Apras4356/Security-System/docs/IMG_20260613_052000.jpg

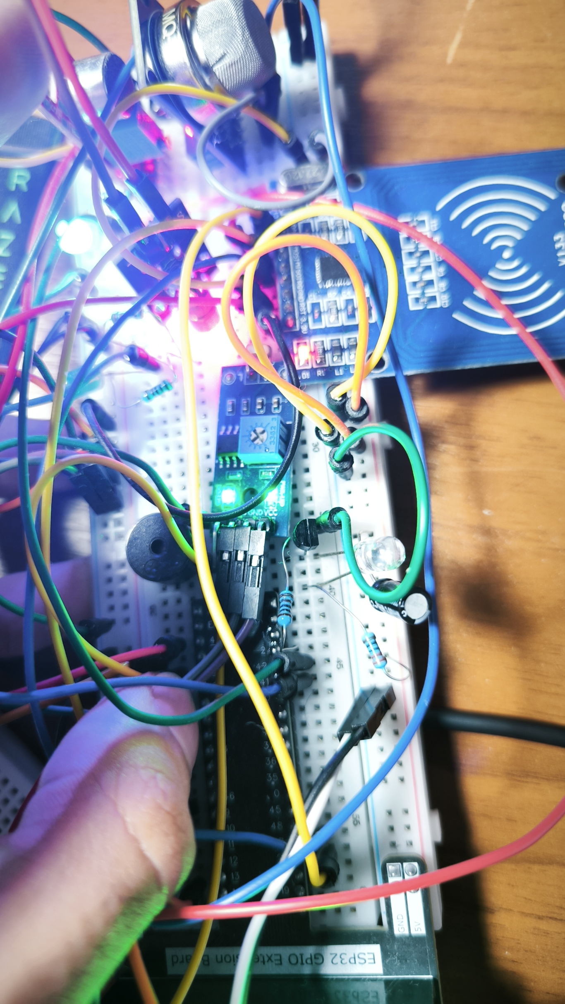
docs/IMG_20260613_052000.jpg
