Apras4356/Security-System/docs/Security System Documentation.odt

# 📖 Documentation: IoT Security System

This documentation covers the architecture, hardware connections, and software configuration for a dual-ESP32 IoT security system. The system is split into two microcontrollers:

1. The Brain (ESP32-S3): Handles the web server, RFID access control database, laser tripwire logic, and Telegram API notifications.
2. The Mouth (ESP32): A dedicated audio co-processor that acts as a Bluetooth A2DP Source to loop a siren over a wireless speaker when triggered.

## 1. System Overview: Audio Co-Processor ("The Mouth")

This code runs on a secondary ESP32 microcontroller dedicated entirely to handling wireless audio playback. It connects to a specific Bluetooth speaker (EDIFIER S351DB). It waits in standby mode, silently listening to a Serial (UART) connection. When it receives a trigger command from the primary Security Panel ESP32 ("The Brain"), it instantly loops a pre-loaded raw audio file (PCM) and activates a visual warning LED.

Offloading the Bluetooth A2DP stream to this secondary board is crucial, as audio processing consumes significant memory and CPU cycles that would otherwise destabilize the primary web server and RFID scanner.

## 2. Hardware Connections & Pinout

To facilitate communication, the two ESP32s must be wired together using their Hardware UART pins.

- Pin 16 (RX2): Connects to the TX2 pin of the Main ESP32. Receives commands.
- Pin 17 (TX2): Connects to the RX2 pin of the Main ESP32. (Optional, used if the Mouth ever needs to send acknowledgment data back).
- Pin 22: Data pin for the WS2812B NeoPixel RGB LED.
- GND: You must connect the Ground (GND) pins of both ESP32s together. Without a shared ground, the Serial communication will fail or transmit garbage data.

## 3. Library Dependencies

Ensure the following libraries are installed in your Arduino IDE or PlatformIO environment:

- Adafruit_NeoPixel: Manages the RGB LED state.
- ESP32-A2DP (by pschatzmann): The core library that provides BluetoothA2DPSource.h to turn the ESP32 into a Bluetooth audio broadcaster.
- seinagermos.h: A custom, local header file containing the raw PCM audio data stored as a C-array (seinagermos), along with its length (seinagermos_len). (See Section 7 for creation instructions).

## 4. Core Architecture & Logic

### State Management

The system relies on a single volatile boolean flag: isAlarmTriggered.

- When false: The Bluetooth stream outputs pure silence (zeros). The LED is off.
- When true: The Bluetooth stream reads from the seinagermos.h array, looping infinitely. The LED turns solid red.

### Audio Streaming Callback (get_audio_data)

This is the heart of the Bluetooth audio generation. The A2DP library constantly runs this function in the background, requesting chunks of audio data to transmit to the Bluetooth speaker.

1. Silence Generation: If the alarm is disarmed (!isAlarmTriggered), it feeds 0 to both the left and right audio channels. This keeps the Bluetooth connection alive without producing sound.
2. Audio Playback: If triggered, it pulls the exact audio frame from the seinagermos PCM array.
3. Infinite Looping: It tracks its position using current_pcm_index. If this index hits the total number of frames, it instantly snaps back to 0, creating an endless, seamless siren loop.

## 5. Function Reference

### setup()

- Initializes the primary serial monitor (115200 baud) for debugging.
- Initializes the hardware UART serial port (Serial2 at 9600 baud) to communicate with the Main ESP32.
- Turns off the NeoPixel LED.
- Initiates the Bluetooth search and connection exclusively to the designated speaker.

### loop()

This function strictly monitors the UART serial buffer for incoming 1-byte character commands from the Main ESP32.

- Receiving 'A' (Alarm):
  - Resets the audio track to the very beginning (current_pcm_index = 0).
  - Sets isAlarmTriggered = true to unmute the audio stream.
  - Turns the NeoPixel LED bright Red.
- Receiving 'S' (Stop/Standby):
  - Sets isAlarmTriggered = false to instantly mute the audio stream.
  - Turns the NeoPixel LED off.

## 6. Integration Notes (How the Boards Talk)

When the Main ESP32's laser tripwire is broken, the Brain runs triggerSeinagermos(), which executes Serial2.println("A");. This fires the 'A' character over the RX/TX wires to Pin 16 of this secondary ESP32, instantly triggering the Bluetooth speaker. When a valid RFID card is scanned, the Brain runs disarmSystem(), executing Serial2.println("S");, forcing this secondary board to mute itself.

## 7. Audio File Conversion Guide (Creating seinagermos.h)

Because the ESP32 lacks a traditional file system, the raw audio waves must be translated into hexadecimal numbers (e.g., 0xFA, 0x1B) and stored directly in the ESP32's flash memory.

Memory Constraint Warning: Uncompressed raw audio is large. Keep your siren loop between 2 to 4 seconds maximum (~350KB to 700KB) to ensure it fits comfortably within the ESP32's available program memory.

### Step 7.1: Format the Audio in Audacity

The Bluetooth A2DP library requires a strict audio format: 44.1kHz, 16-bit, Stereo.

1. Open your audio file in Audacity.
2. Convert to Stereo: If the track is Mono, duplicate it and join the two tracks to create a Stereo track.
3. Set Project Rate: In the bottom left corner, change the Project Rate (Hz) to 44100.
4. Trim the audio to a clean 2-3 second loop.

### Step 7.2: Export as RAW PCM

1. Go to File > Export > Export Audio.
2. Apply the following settings exactly:
  - Save as type / Format: Other uncompressed files
  - Header: RAW (header-less)
  - Encoding: Signed 16-bit PCM
3. Export the file as seinagermos.raw. Check the file properties on your computer and note the exact file size in bytes—you will need this number.

### Step 7.3: Convert the RAW file to a C-Array

1. Use a hex converter tool, such as tomeko.net's File to C array converter.
2. Upload seinagermos.raw and convert it.
3. Copy the resulting output (the block of text starting with 0x00, 0x00...).

### Step 7.4: Create the Header File

1. In your project, create a new file named seinagermos.h.
2. Paste the following template, inserting your specific byte length and hex data:

C++

#pragma once

#include <stdint.h>

#include <pgmspace.h> // Forces the ESP32 to save this in flash memory, not RAM

// IMPORTANT: Replace '352800' with the exact file size (in bytes) of your .raw file

const uint32_t seinagermos_len = 352800;

// Paste your converted hex data between the brackets

const uint8_t seinagermos[] PROGMEM = {

// PASTE YOUR HEX DATA HERE:

0x00, 0x00, 0x00, 0x00, 0xFE, 0xFF, 0x1A, 0x2B, // ...

};

Note: The PROGMEM keyword is critical. Without it, the ESP32 will try to load the entire audio file into its active RAM and crash instantly.

## 8. PlatformIO Configurations (platformio.ini)

Because this project utilizes heavy audio processing and a complex web server/database, standard Arduino IDE compiler settings will fail. The platformio.ini files for both boards are specifically tuned for these workloads.

### The "Brain" Configuration (Security Panel)

Ini, TOML

[env:4d_systems_esp32s3_gen4_r8n16]

platform = espressif32

board = 4d_systems_esp32s3_gen4_r8n16

framework = arduino

monitor_speed = 115200

lib_deps =

adafruit/Adafruit NeoPixel@^1.15.4

marcoschwartz/LiquidCrystal_I2C@^1.1.4

miguelbalboa/MFRC522@^1.4.12

- Architecture: Uses the ESP32-S3 (4d_systems_esp32s3_gen4_r8n16), providing ample RAM to chew through web server rendering, array shifting for the RFID database, and secure HTTPS API requests.
- Native Core Libraries: Libraries like WiFi, WebServer, Preferences, HTTPClient, and ESPmDNS are native to the espressif32 core. Therefore, they do not need to be declared in lib_deps to prevent dependency conflicts.

### The "Mouth" Configuration (Audio Co-Processor)

Ini, TOML

[env:esp32doit-devkit-v1]

platform = espressif32

board = esp32doit-devkit-v1

framework = arduino

board_build.partitions = huge_app.csv

monitor_speed = 115200

lib_ldf_mode = deep+

upload_speed = 115200

lib_deps =

adafruit/Adafruit NeoPixel@^1.15.4

https://github.com/pschatzmann/ESP32-A2DP.git

- board_build.partitions = huge_app.csv (Critical): By default, PlatformIO allocates ~1.2MB for code. The Bluetooth A2DP library combined with the giant seinagermos.h raw audio array will trigger a "Sketch too large" compiler error. The huge_app.csv partition scheme wipes out the OTA (Over-The-Air) update space, allocating a massive 3MB block for your program to fit perfectly.
- lib_ldf_mode = deep+: The ESP32-A2DP library features complex, nested dependencies. This directive forces the PlatformIO Library Dependency Finder (LDF) to parse all nested headers thoroughly, preventing random "Header file not found" compilation errors.
- Direct Git Sourcing: Pulling the A2DP library directly from its GitHub repository ensures the compiler grabs the latest Bluetooth stability patches instead of relying on outdated registry versions.
- Upload Speed: Set safely at 115200 to prevent corruption of the large audio array over the USB cable. (Note: Flashing will take 30-60 seconds. If impatient, this can be safely tested at 921600 depending on the quality of your USB cable).

## 🔌 Hardware Wiring Guide & Pinout

This section details the exact physical connections required to link the microcontrollers, sensors, and peripherals.

### 1. Power Distribution (Critical!)

Proper power management is the most important part of this build. Failure to wire the grounds correctly will result in serial communication failure between the two boards.

⚠️ CRITICAL: Shared Ground

The GND pin on "The Brain" MUST be physically connected to the GND pin on "The Mouth". All modules (RFID, Mic, Laser, Buzzer, LCD, LEDs) must also share this common ground.

- 3.3V Logic: Connect the 3.3V pin on the ESP32-S3 to the VCC/3.3V pins on the RFID, Microphone, and Laser modules.
- 5V Logic: Connect the 5V (or VIN/VBUS) pin to the VCC on the I2C LCD Screen. (Note: Most I2C LCDs require 5V to power the backlight and display text clearly).

### 2. "The Brain" (ESP32-S3 Security Panel)

This board handles the core logic, web server, and sensor monitoring.

Component | ESP32-S3 Pin | Code Variable | Function / Notes
Mouth ESP32 (RX) | Pin 17 | TX2_PIN | Sends 'A' and 'S' serial commands to the Mouth.
Mouth ESP32 (TX) | Pin 16 | RX2_PIN | Receives data. (Optional, but good practice)
RFID Reader (SDA/SS) | Pin 21 | SS_PIN | SPI Chip Select
RFID Reader (SCK) | Pin 12 | SPI_SCK | SPI Clock
RFID Reader (MOSI) | Pin 11 | SPI_MOSI | SPI Master Out Slave In
RFID Reader (MISO) | Pin 13 | SPI_MISO | SPI Master In Slave Out
RFID Reader (RST) | Pin 14 | RST_PIN | Hardware Reset
LCD Screen (SDA) | Pin 8 | I2C_SDA | I2C Data Line
LCD Screen (SCL) | Pin 9 | I2C_SCL | I2C Clock Line
Microphone (OUT) | Pin 4 | MIC_PIN | Digital out from sound sensor
Laser Receiver (OUT) | Pin 5 | laserReceiverPin | Digital out from light sensor
Buzzer (+) | Pin 6 | BUZZER_PIN | Active buzzer PWM control
Wi-Fi LED (+) | Pin 42 | wifiLed | Needs a 220Ω-330Ω resistor in series to GND
Arming Button | Pin 47 | resetButton | Connects to 3.3V when pressed (Active HIGH)
RGB Status LED | Pin 48 | LED_RGB | Data pin for the WS2812 NeoPixel

### 3. "The Mouth" (ESP32 Audio Co-Processor)

This board strictly handles the Bluetooth A2DP audio streaming and warning lights.

Component | ESP32 Pin | Code Variable | Function / Notes
Brain ESP32 (TX) | Pin 16 | RX2_PIN | Receives 'A' and 'S' commands from the Brain.
Brain ESP32 (RX) | Pin 17 | TX2_PIN | Sends data back. (Optional)
Warning RGB LED | Pin 22 | N/A | Data pin for the visual warning NeoPixel

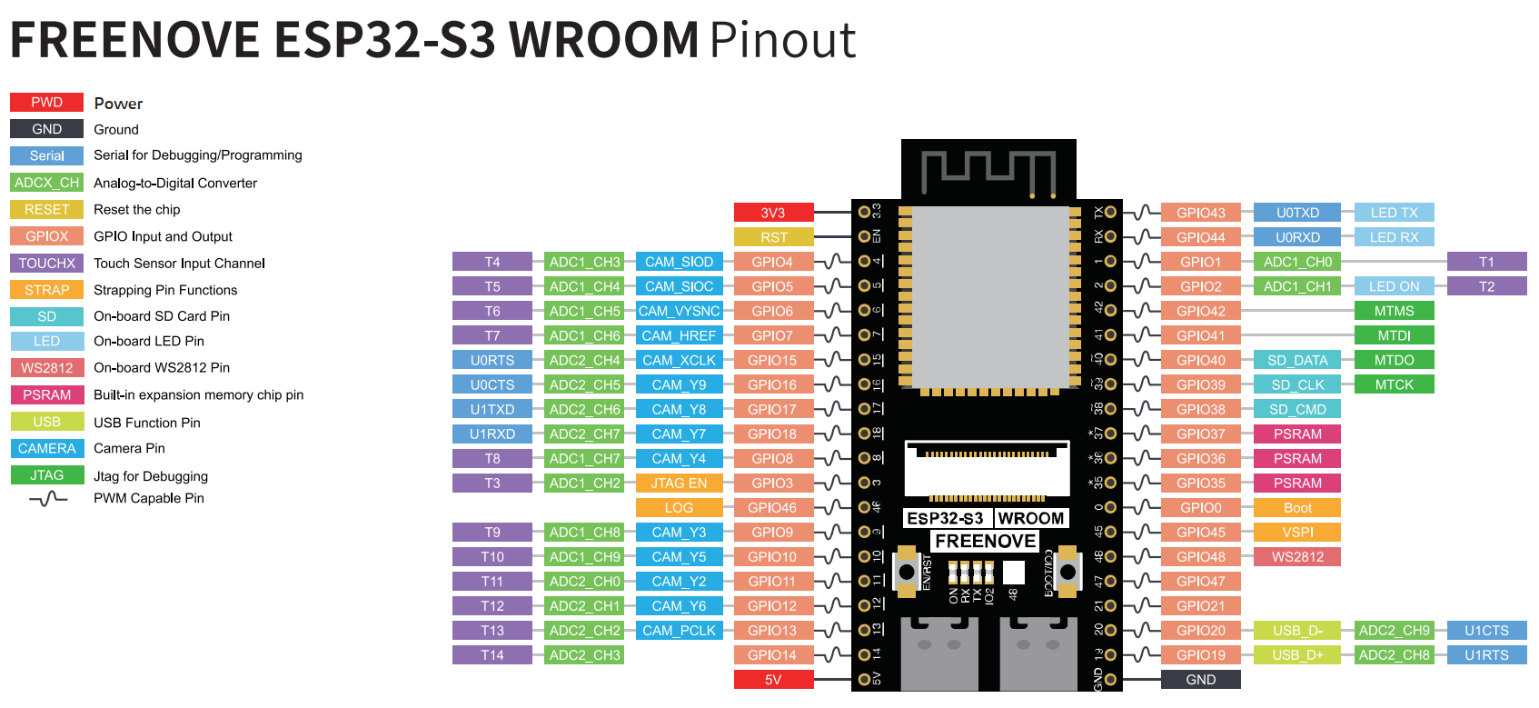
[picture p2: figure]
