Apras4356/Security-System/docs/Παρουσίαση Hackathon Integrated secure system.odp

## Hackathon 2026 Omnishield Omnimesh | Integrated secure room technology Μέλη ομάδας: Γκιουζελάκης Αναστάσιος Τσαπακίδης Γιώργος Συνοπτική περιγραφή: Σύστημα ασφαλείας με έλεγχο πρόσβασης μέσω κινητού και ιστοσελίδας

## Ορισμός του προβλήματος

Το πρόβλημα που καλούμαστε να λύσουμε στα πλαίσια του 2ήμερου HACKATHON, είναι η έλλειψη ενός χαμηλού κόστους access control και security system, αξιόπιστου με βάση το κόστος του χώρου που προστατεύει και ταυτόχρονα η εύκολη εγκατάσταση του συστήματος.

## Διαφοροποίηση με ανταγωνιστές

Με το ελάχιστο δυνατό κόστος και αξιοποιώντας όσες το δυνατόν περισσότερες ηλεκτρικές συσκευές είναι διαθέσιμες σε ένα σπίτι, δημιουργούμε έναν μηχανισμό ασφαλείας, που αποτελείται από access control κεντρικής εισόδου, microcontroller ESP32 και ένα κινητό. Επιπλέον εξαρτήματα είναι διαθέσιμα, ανάλογα με τις ανάγκες του χώρου.

## Λύση του προβλήματος & καινοτομία της ιδέας

Η ομάδα μας ανέπτυξε ένα οικονομικά αποδοτικό, πλήρως παραμετροποιήσιμο και εκπαιδευτικά επωφελές σύστημα με χρήση μικροελεγκτή ESP32 custom λογισμικό ξεκινώντας από την επιχειρηματική έρευνα που υποστηρίζει το Ε.Μ.Π ως SPIN-OFF με στόχο να εξελιχθεί σε μια μελλοντική, εμπορικά βιώσιμη λύση στην αγορά του οικιακού αυτοματισμού και ασφάλειας.

Παρέχουμε το σύστημα σε 2 εκδόσεις.

- Home edition | Omnishield Home
- Professional | Omnishield Pro

## Ευκαιρίες αγοράς

- 1. Στάδιο
  Πιλοτική λειτουργία του προϊόντος μας στη σχολή Πολιτικών Μηχανικών Ε.Μ.Π.
  Εμφάνιση σφαλμάτων.
  Καταγραφή προβλημάτων δοκιμών.
  Επιδιόρθωση προβλημάτων πιλοτικής λειτουργίας.

## Ευκαιρίες αγοράς

- 2ο στάδιο.
  Διάθεση του προϊόντος στην αγορά.
  Target group: Ιδιώτες, που θέλουν για την ασφάλεια του χώρου τους, δαπανώντας ποσό κάτω του μέσου όρου κόστους συστημάτων συναγερμού του εμπορίου.

## Ευκαιρίες αγοράς

- Το κόστος αγοράς αντίστοιχων εξαρτημάτων κυμαίνεται από 100 έως 300€ (πηγή aliexpress).
- Το κόστος υλικών της υπηρεσίας μας ξεκινάει από 50€ και αυξάνεται ανάλογα με τα παρελκόμενα που θέλει να προσθέσει ο τελικός χρήστης.

## Λειτουργία προϊόντος

- Wifi mesh για ανίχνευση κίνησης με τον βασικό εξοπλισμό μέσω του router και πρόσθετων access point συσκευών.
- Χρήση ήδη υπάρχοντων συσκευών για την εξασφάλιση της ασφάλειας (πχ ηχεία, κάμερα, ανιχευτής φωτιάς).
- Sensor Fusion κάμερας και wifi για τη συγχώνευση δεδομένων.
- Υποστήριξη access control για εξατομικευμένη πρόσβαση σε χώρους
- Απομακρυσμένη πρόσβαση για παραμετροποίηση και έλεγχο του συστήματος
- Ευκολία τοποθέτησης, plug and play, με ελάχιστο χρόνο εγκατάστασης

## Κοινωνικό αποτύπωμα της λύσης

- Ο μηχανισμός μπορεί να μεταμορφωθεί σε σύστημα υποστήριξης ευάλωτων ομάδων. Για παράδειγμα, η ανάλυση του σήματος WiFi μπορεί να ανιχνεύσει πτώση ή παρατεταμένη ακινησία ενός ηλικιωμένου, στέλνοντας αυτόματη ειδοποίηση στους οικείους του.
- Δεν απευθύνεται μόνο σε ανθρώπους που θέλουν να κατανοήσουν, να τροποποιήσουν και να επεκτείνουν την τεχνολογία του σπιτιού τους, αλλά και στον μέσο ιδιώτη που θέλει μια εύκολη λύση, αποδεικνύοντας ότι η τεχνολογία χαμηλού κόστους μπορεί να έχει υψηλή τεχνολογική αξία.

## Ερωτήσεις;

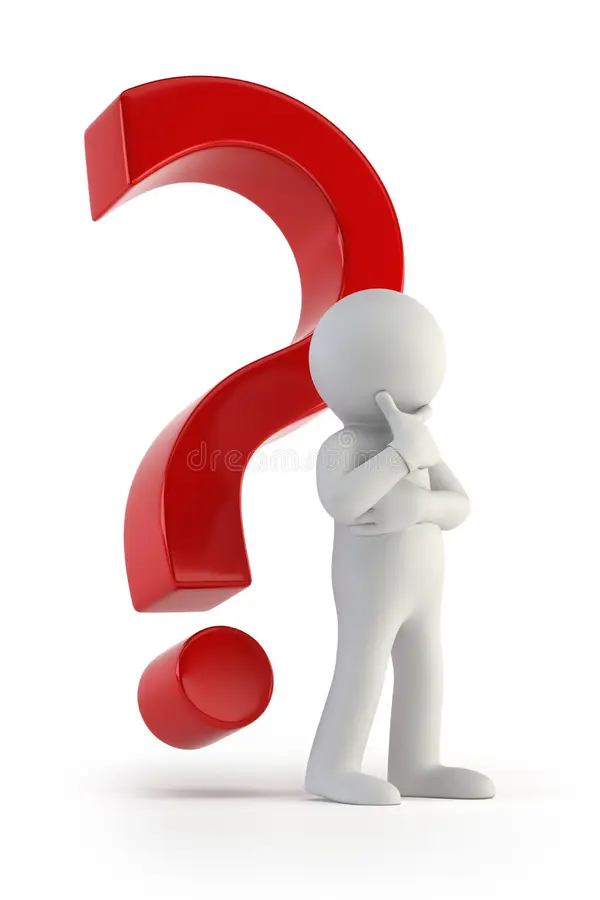
[picture p4: figure]

## Ευχαριστίες

Ευχαριστούμε το κέντρο καινοτομίας και επιχειρηματικότητας του Ε.Μ.Π για την ευκαιρία να συμμετάσχουμε στο HACKATHON @ NTUA
