Apras4356/Security-System/hardware/3d-models/outside module 1.stl

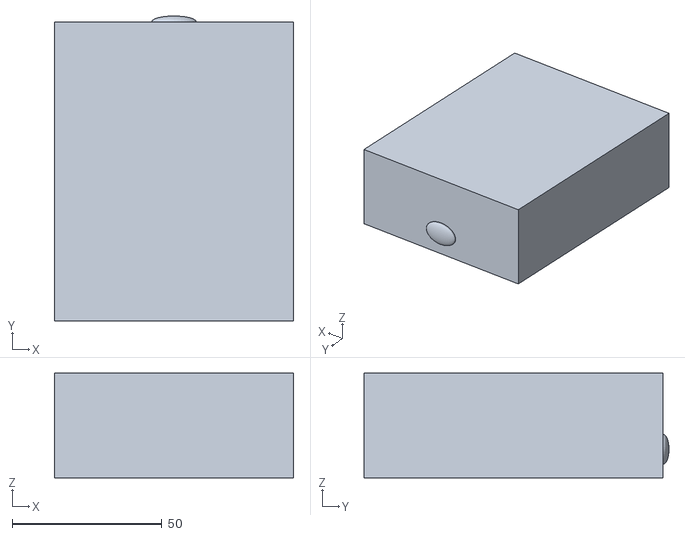
[picture p5: CAD file, 2026-11-09]
hardware/3d-models/outside module 1.stl
80.0 x 102.0 x 35.0
