Apras4356/Security-System/hardware/3d-models/Enclosure_Lid.stl

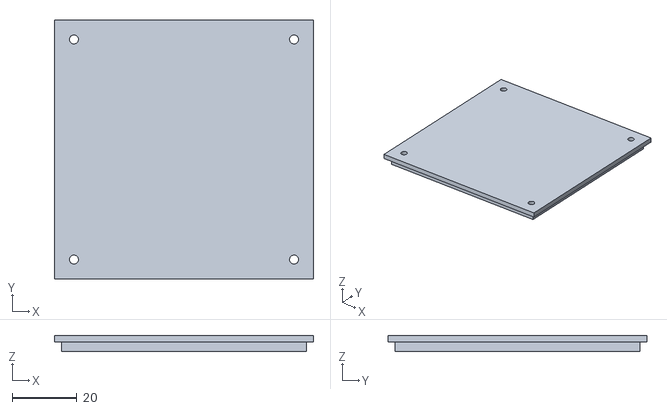
[picture p6: CAD file, 2026-11-09]
hardware/3d-models/Enclosure_Lid.stl
80.0 x 80.0 x 5.00
