Apras4356/Security-System/hardware/3d-models/Base.stl

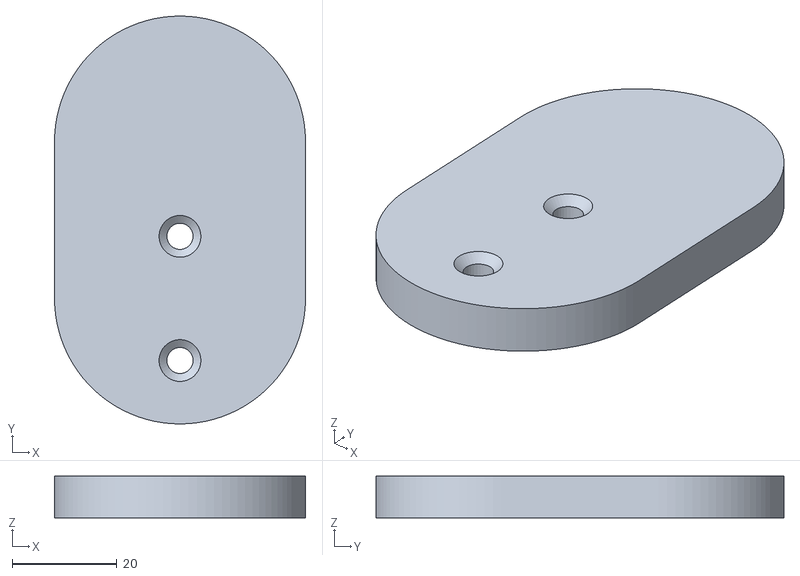
[picture p7: CAD file, 2026-11-09]
hardware/3d-models/Base.stl
48.0 x 78.0 x 8.00
