Apras4356/Security-System/hardware/3d-models/freecad box.FCStd

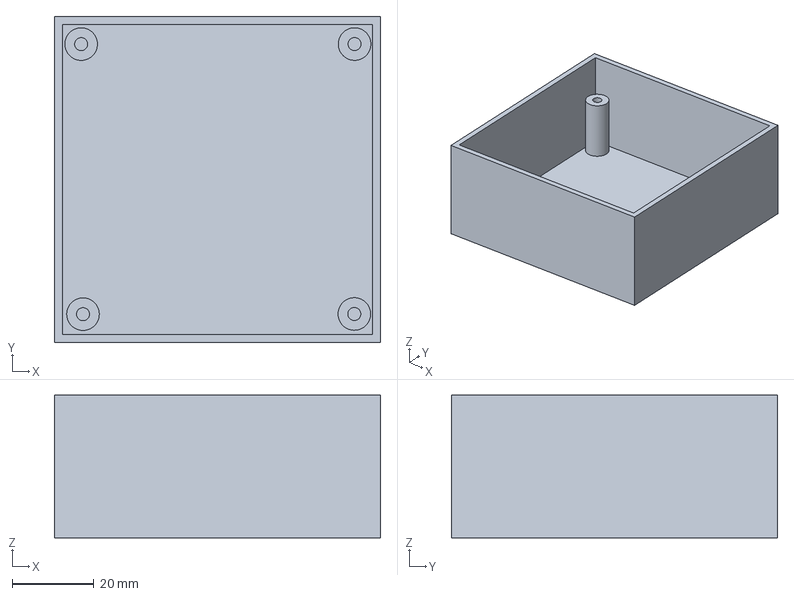
[picture p8: CAD file, 2026-11-09]
hardware/3d-models/freecad box.FCStd
80.0 x 80.0 x 35.0 mm
