Apras4356/Security-System/hardware/3d-models/Enclosure_Box.stl

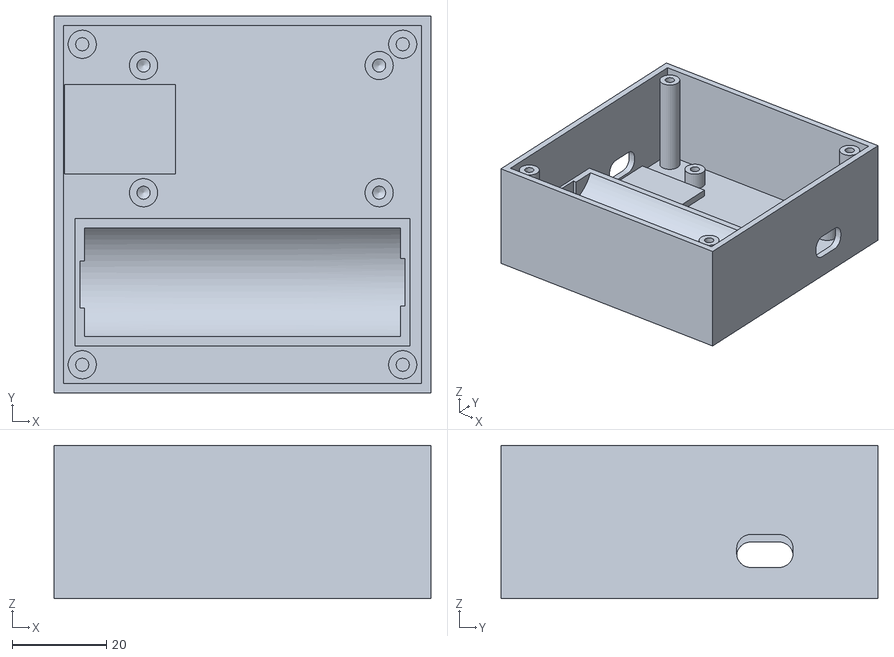
[picture p10: CAD file, 2026-11-09]
hardware/3d-models/Enclosure_Box.stl
80.0 x 80.0 x 32.5
