Apras4356/Security-System/hardware/3d-models/box refined.stl

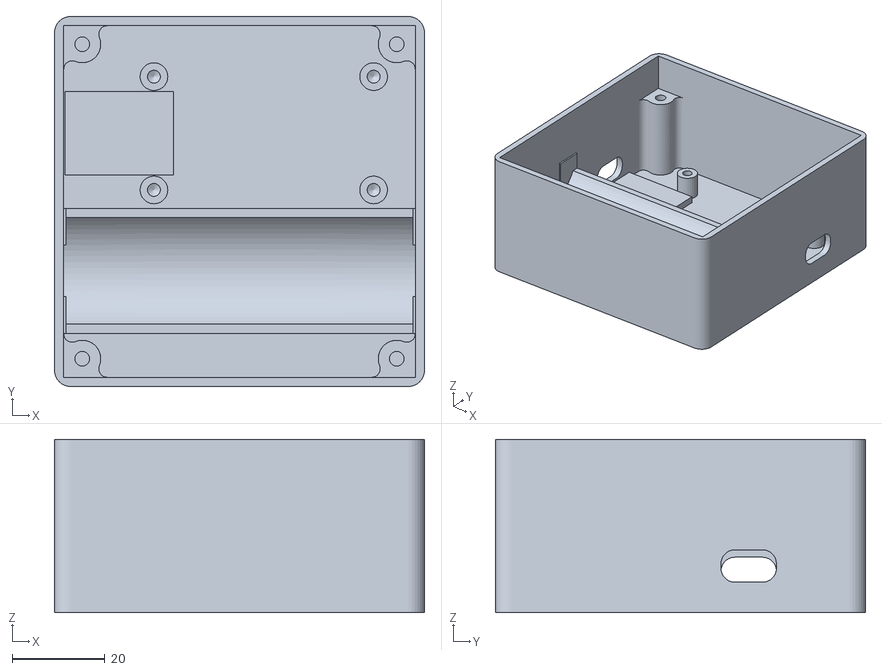
[picture p11: CAD file, 2026-11-09]
hardware/3d-models/box refined.stl
80.0 x 80.0 x 37.5
