Apras4356/Security-System/hardware/3d-models/Enclosure_Box_Screwed.3mf

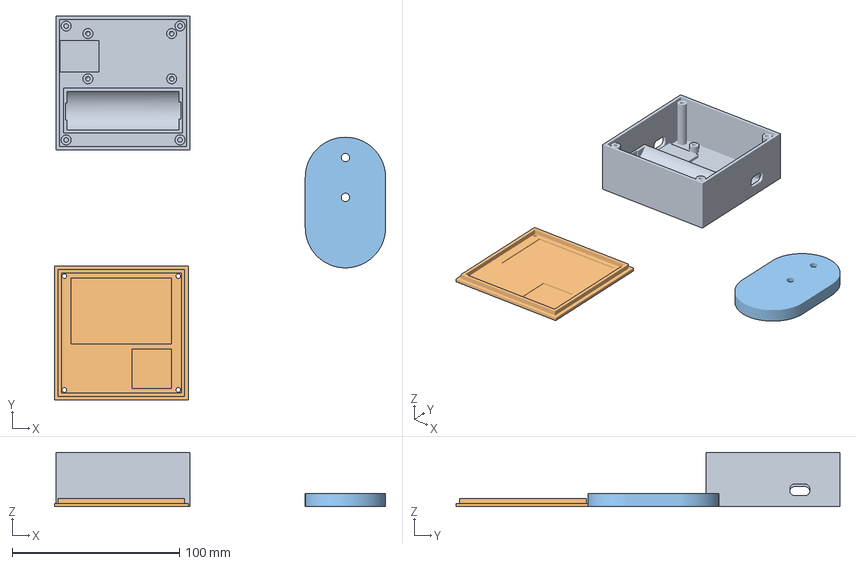
[picture p12: CAD file, 2026-11-09]
hardware/3d-models/Enclosure_Box_Screwed.3mf
197.8 x 229.3 x 32.5 mm
Enclosure_Box.stl
Enclosure_Lid.stl
Base.stl
