Apras4356/Security-System/(list of files, cad)

Other CAD files:
hardware/3d-models/outside module.blend
