Apras4356/Security-System/hardware/pinouts/Wiring gia to ejw esp32.png

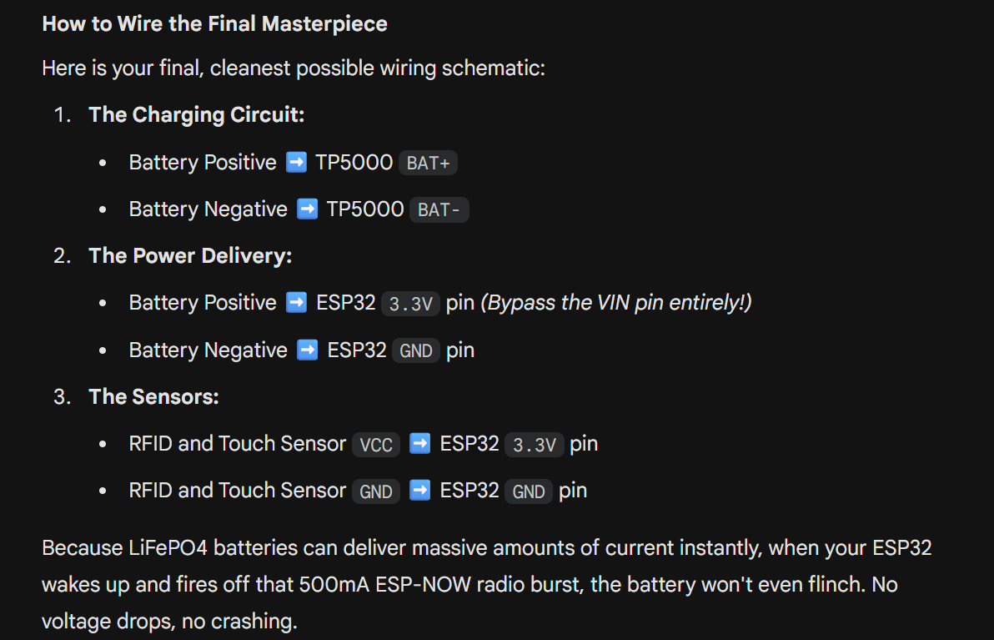
hardware/pinouts/Wiring gia to ejw esp32.png
