Apras4356/Security-System/(commit log)

2026-06-13 Smoke Detector and Telegram Fix
    [Config.h, IRManager.cpp, SecurityManager.cpp, SecurityManager.h, TelegramManager.cpp, WebPages.h]
2026-06-13 Added Button Timer
2026-06-26 Wifi trip button
2026-11-09 fix(security): enforce strictly monotonic counter in NVS and add remote unpair endpoint
    [Config.h, Globals.h, WebPages.h, main.cpp]
2026-11-09 fix(security): persist monotonic counter in NVS for strict replay attack prevention
    [main.cpp]
2026-11-09 feat: add 3D printable enclosures, PCB designs, multi-root workspace, and documentation
    [Base.stl, Enclosure_Box.stl, Enclosure_Box_Screwed.3mf, Enclosure_Lid.stl, box refined.stl, freecad box.FCStd, lid refined.stl, outside module 1.stl]
2026-11-09 chore: remove embedded .history directory from hardware/pcb
2026-11-09 docs: add bilingual Greek and English documentation with language switcher
2026-11-09 chore: remove PCB backup zips from tracking and ignore backup files
