Apras4356/Security-System/(notices)

Notices in the files:
README.md:
License: MIT
